josephdcaputo/microdox-tent/docs/fit_template_1to1_letter.pdf

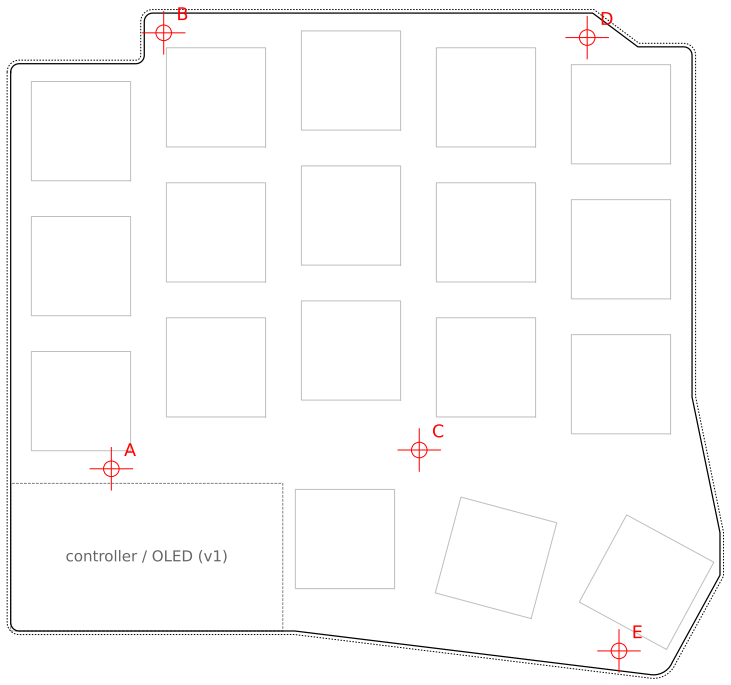
[picture p3: figure]
controller / OLED (v1)

100 mm - measure this. If it isn't 100 mm, the print is scaled: reprint at 100% / Actual size

100 mm

# Microdox LEFT half - 1:1 fit template (v1 outline + holes)

Print at 100% / Actual size (no 'fit to page'). Check both 100 mm bars with a ruler first.
Method 1 (outline): pull the outer keycaps, set the LEFT half switch-side UP on this page, and sight straight down at the PCB edge. Its inner (thumb) edge is on the right.
Method 2 (holes): remove the bottom screws, turn the RIGHT half keycaps-DOWN, and hold THIS page printed side up against its underside (the underside is a mirror image). Push a pin through each red crosshair: it should drop into the mounting hole.
Solid line = v1 PCB edge. Dashed = +0.5 mm. Red = v1 M2 hole centres A-E. Grey = v1 switch cutouts.

MATCH if: board edge sits on or just inside the solid line all the way round (paper tolerance ~0.5 mm)
and every pin drops into its hole without forcing. MISMATCH if: any edge is >1 mm off, or any hole is visibly off-centre -> stop and measure the v2 board (see REFERENCE.md).

Caliper cross-check (hole centre spacing = far-edge to far-edge - 2.2):
A-E 76.11 | B-D 59.76 | C-E 39.98 | A-D 90.62 | outline 100.09 x 93.39 mm
Pass: each within 0.2 mm.

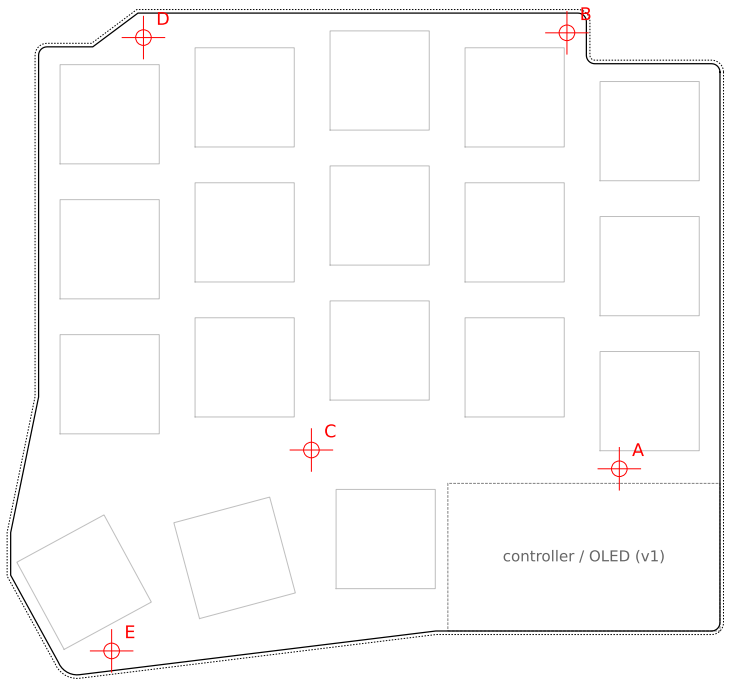
[picture p4: figure]
controller / OLED (v1)

100 mm - measure this. If it isn't 100 mm, the print is scaled: reprint at 100% / Actual size

100 mm

# Microdox RIGHT half - 1:1 fit template (v1 outline + holes)

Print at 100% / Actual size (no 'fit to page'). Check both 100 mm bars with a ruler first.
Method 1 (outline): pull the outer keycaps, set the RIGHT half switch-side UP on this page, and sight straight down at the PCB edge. Its inner (thumb) edge is on the left.
Method 2 (holes): remove the bottom screws, turn the LEFT half keycaps-DOWN, and hold THIS page printed side up against its underside (the underside is a mirror image). Push a pin through each red crosshair: it should drop into the mounting hole.
Solid line = v1 PCB edge. Dashed = +0.5 mm. Red = v1 M2 hole centres A-E. Grey = v1 switch cutouts.

MATCH if: board edge sits on or just inside the solid line all the way round (paper tolerance ~0.5 mm)
and every pin drops into its hole without forcing. MISMATCH if: any edge is >1 mm off, or any hole is visibly off-centre -> stop and measure the v2 board (see REFERENCE.md).

Caliper cross-check (hole centre spacing = far-edge to far-edge - 2.2):
A-E 76.11 | B-D 59.76 | C-E 39.98 | A-D 90.62 | outline 100.09 x 93.39 mm
Pass: each within 0.2 mm.
