josephdcaputo/microdox-tent/docs/images/board_features_top_view_v1.png

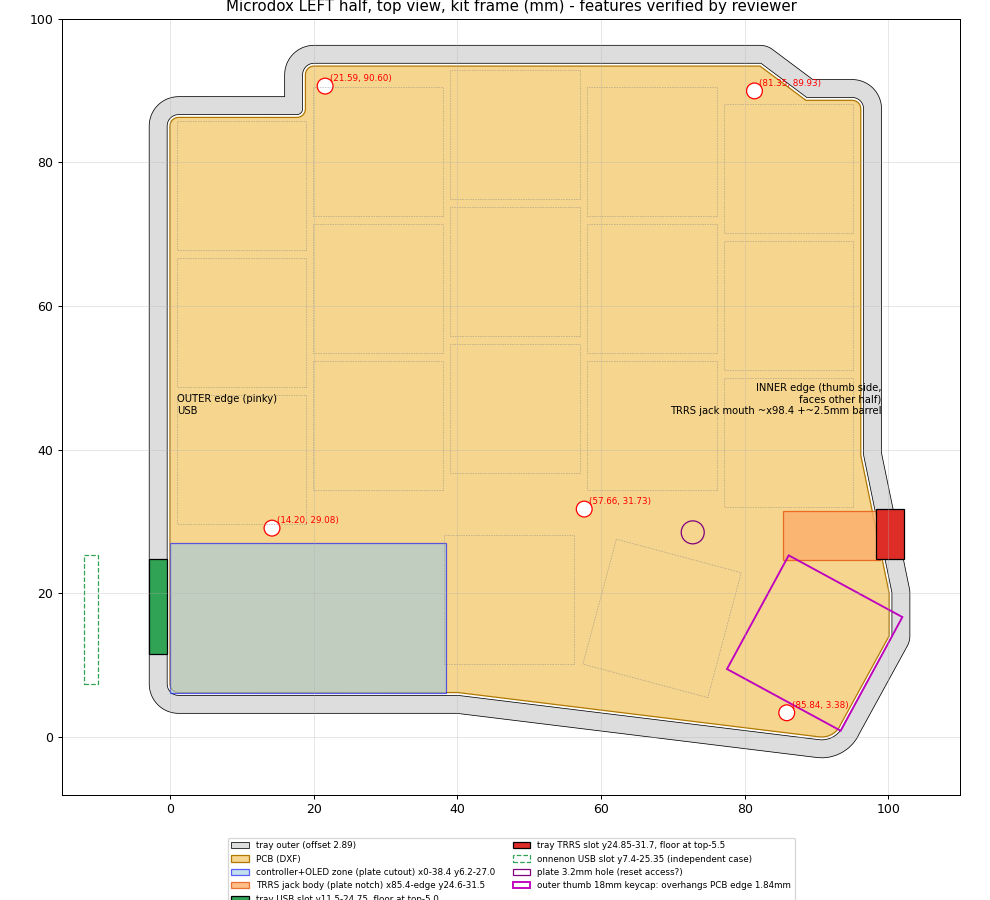
docs/images/board_features_top_view_v1.png
