josephdcaputo/microdox-tent/docs/images/joint_top.png

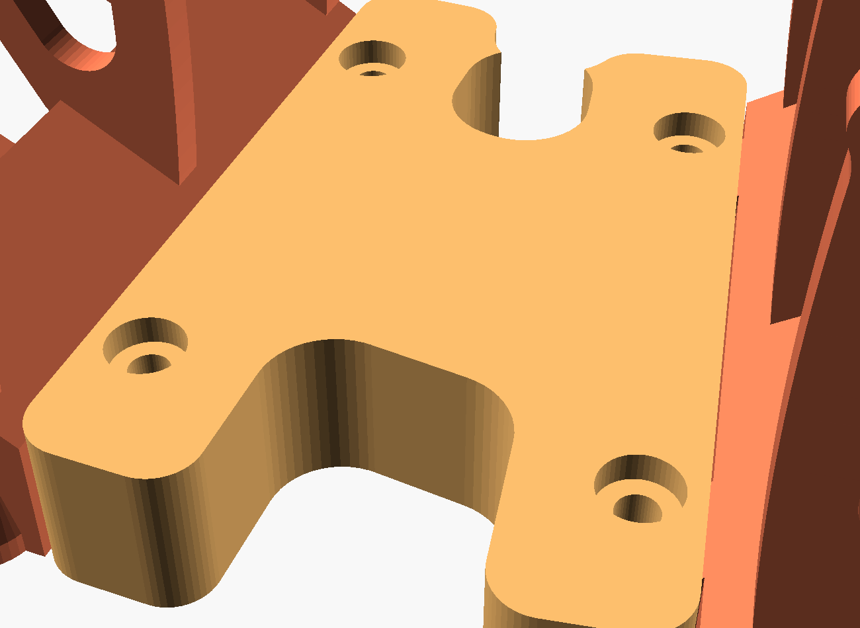
docs/images/joint_top.png
