josephdcaputo/microdox-tent/docs/images/side_views.png

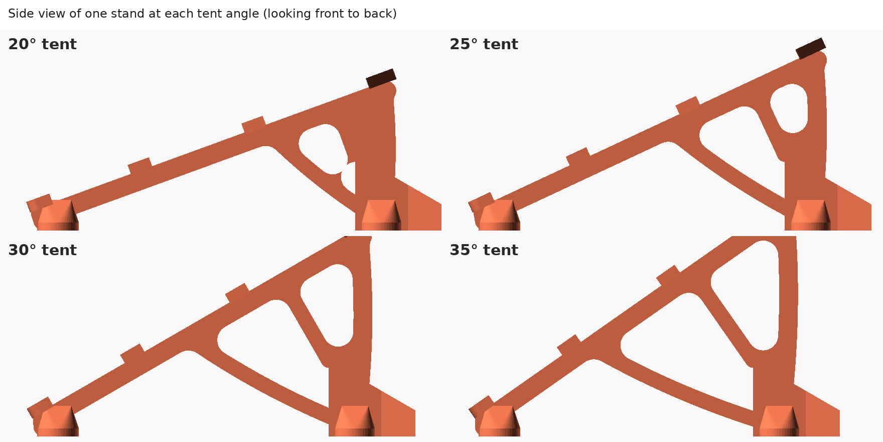
docs/images/side_views.png
