josephdcaputo/microdox-tent/docs/images/stand_underside.png

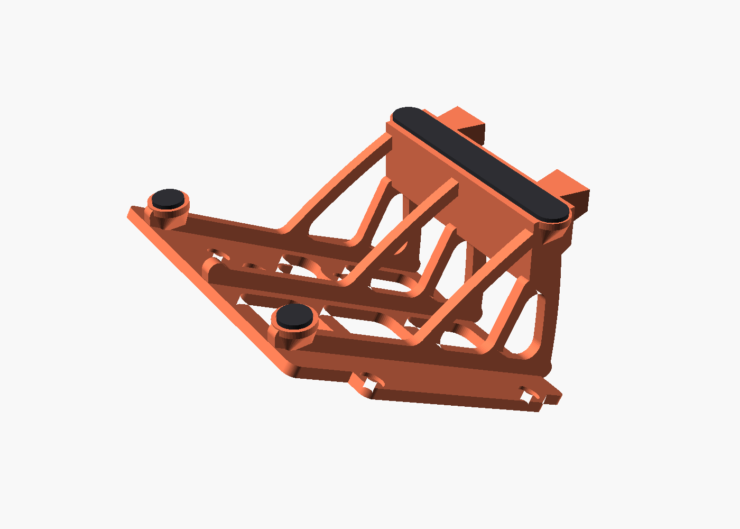
docs/images/stand_underside.png
