josephdcaputo/microdox-tent/reference/microdox_pcb_left.dxf

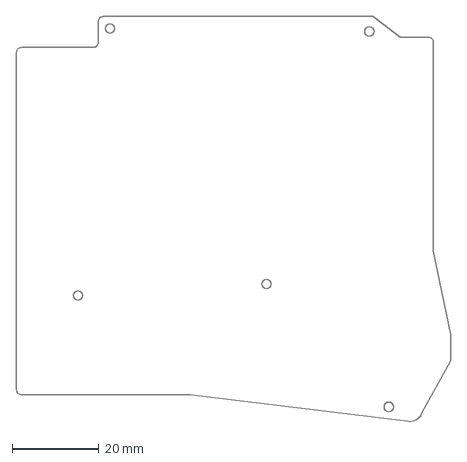
[picture p9: CAD file, 2026-10-17]
reference/microdox_pcb_left.dxf
100.1 x 93.4 mm
