josephdcaputo/microdox-tent/reference/original/Microdox.step

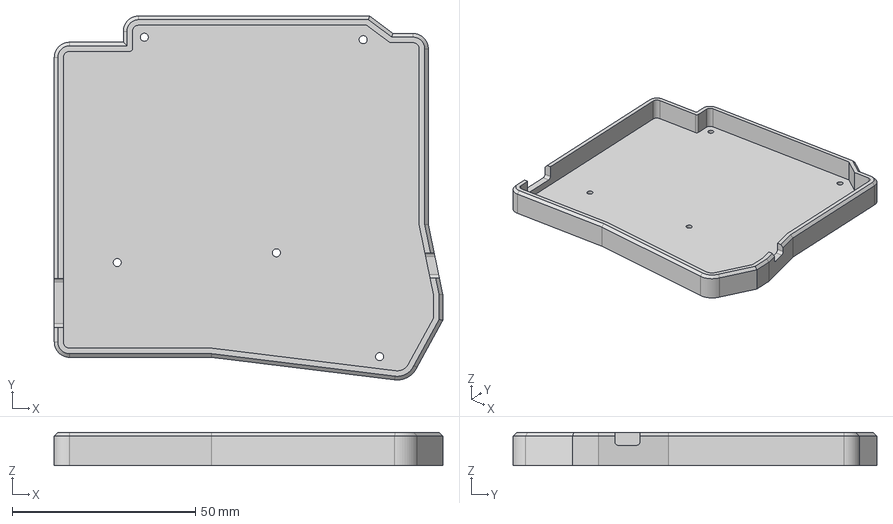
[picture p10: CAD file, 2026-10-17]
reference/original/Microdox.step
105.9 x 99.2 x 9.00 mm
