josephdcaputo/microdox-tent/stl/joint/spacer_45mm_splay10.stl

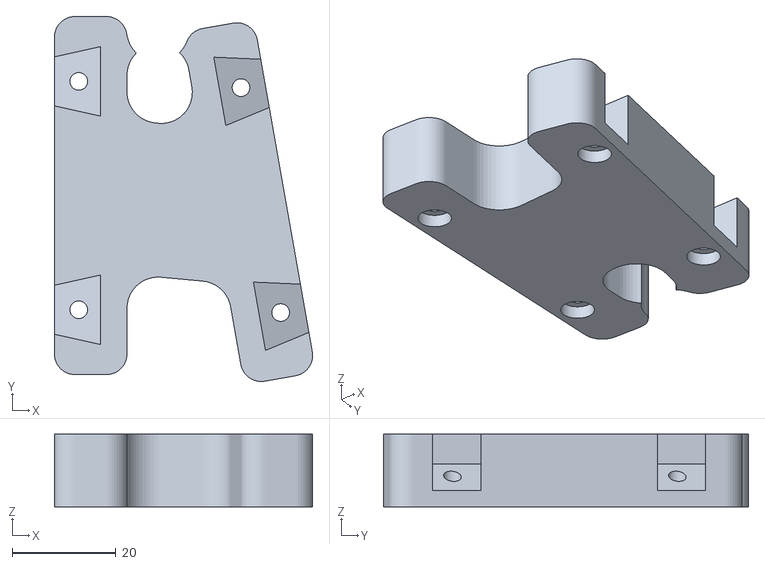
[picture p11: CAD file, 2026-10-17]
stl/joint/spacer_45mm_splay10.stl
49.8 x 70.3 x 14.0
