josephdcaputo/microdox-tent/stl/stands/stand_right_35deg.stl

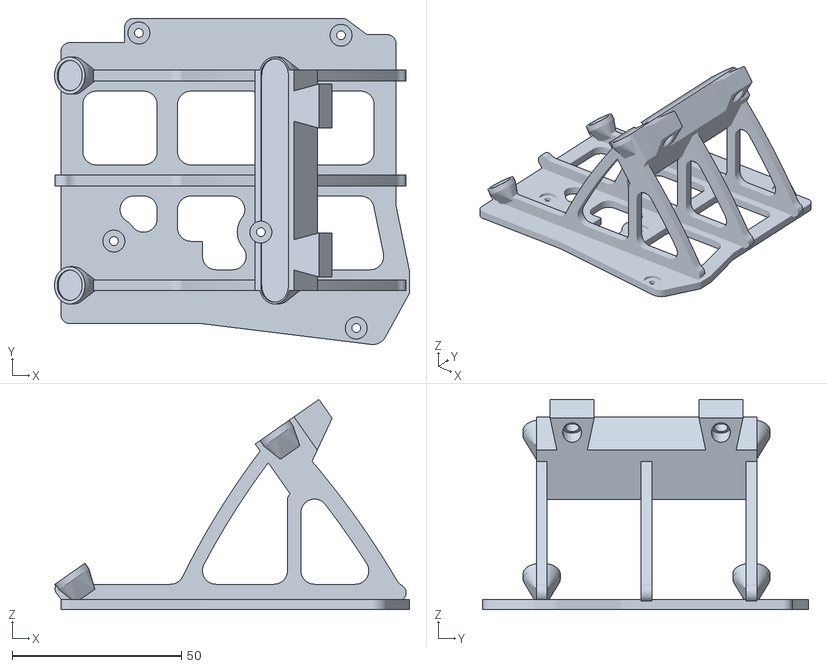
[picture p12: CAD file, 2026-10-17]
stl/stands/stand_right_35deg.stl
105.0 x 96.4 x 62.2
