josephdcaputo/microdox-tent/stl/test-prints/fit_plate.stl

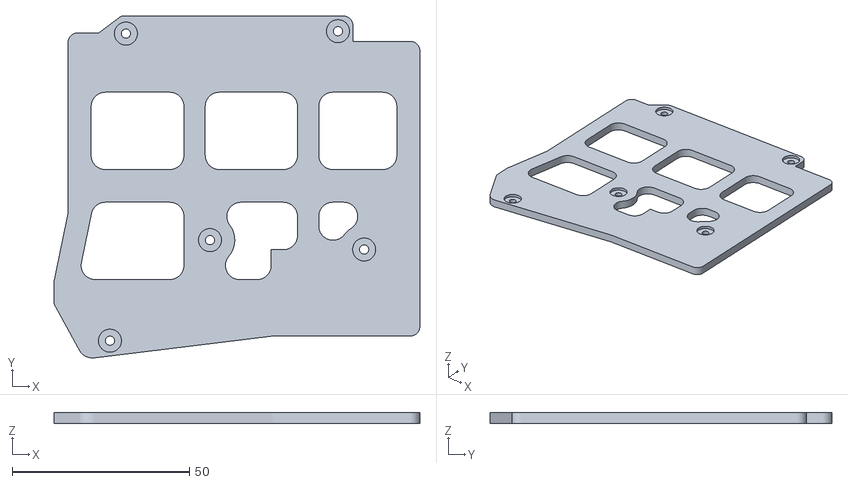
[picture p13: CAD file, 2026-10-17]
stl/test-prints/fit_plate.stl
103.1 x 96.4 x 3.00
