josephdcaputo/microdox-tent/reference/original/micodox bottom outline and holes.dxf

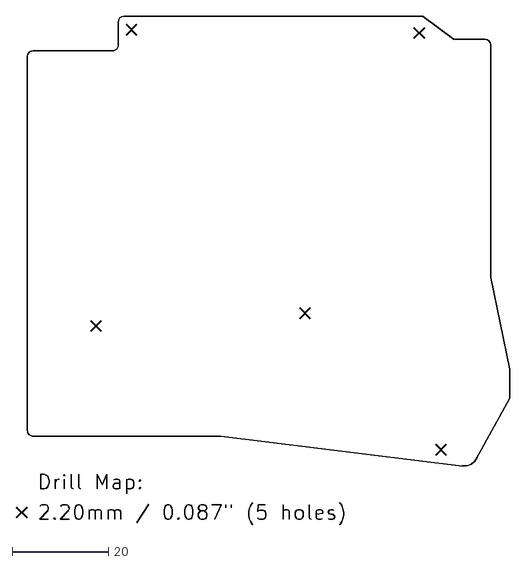
[picture p14: CAD file, 2026-10-17]
reference/original/micodox bottom outline and holes.dxf
102.4 x 105.6
