josephdcaputo/microdox-tent/stl/joint/spacer_80mm.stl

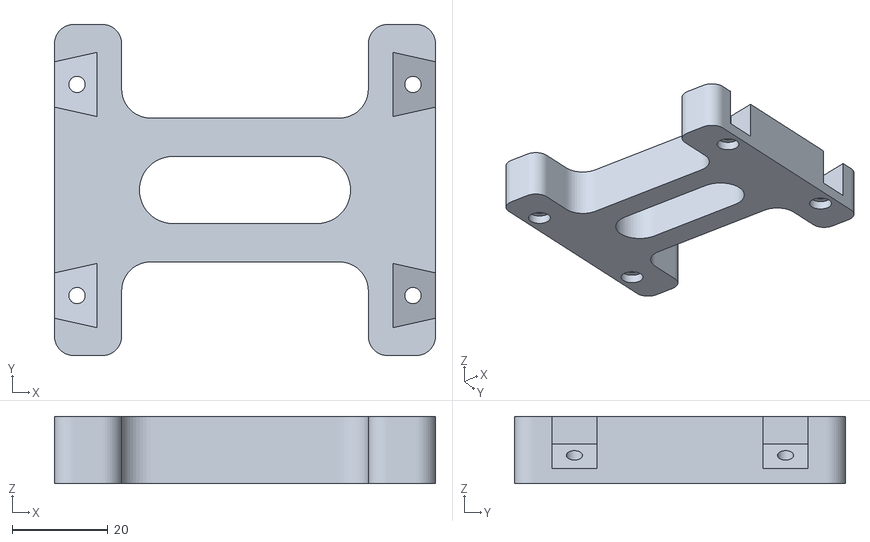
[picture p15: CAD file, 2026-10-17]
stl/joint/spacer_80mm.stl
79.4 x 69.0 x 14.0
