josephdcaputo/microdox-tent/stl/stands/stand_right_20deg.stl

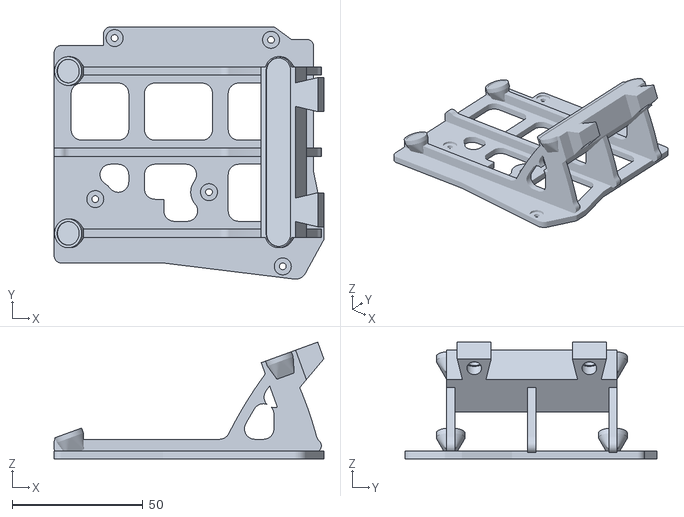
[picture p16: CAD file, 2026-10-17]
stl/stands/stand_right_20deg.stl
103.2 x 96.4 x 44.6
