josephdcaputo/microdox-tent/stl/test-prints/joint_test_tongue.stl

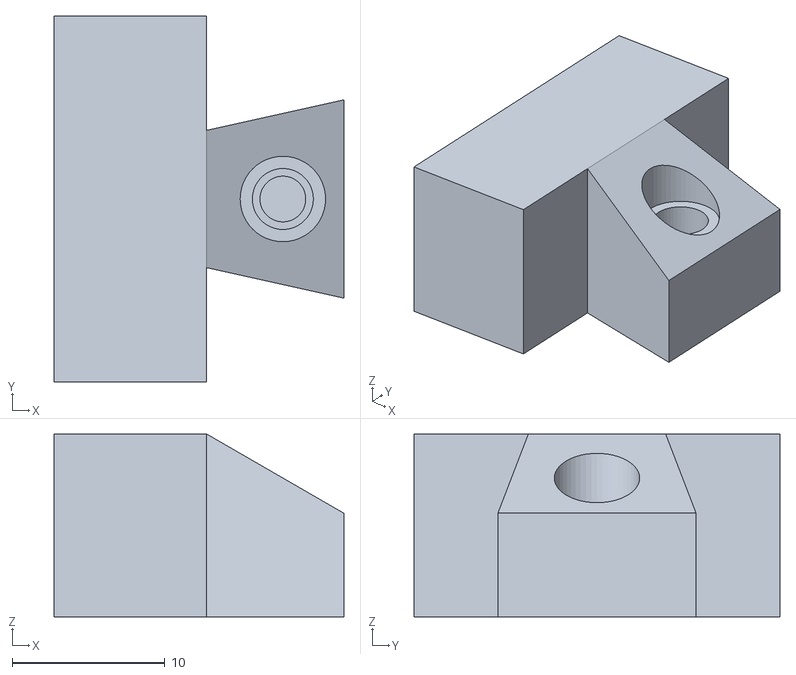
[picture p17: CAD file, 2026-10-17]
stl/test-prints/joint_test_tongue.stl
19.0 x 24.0 x 12.0
