josephdcaputo/microdox-tent/stl/joint/spacer_40mm.stl

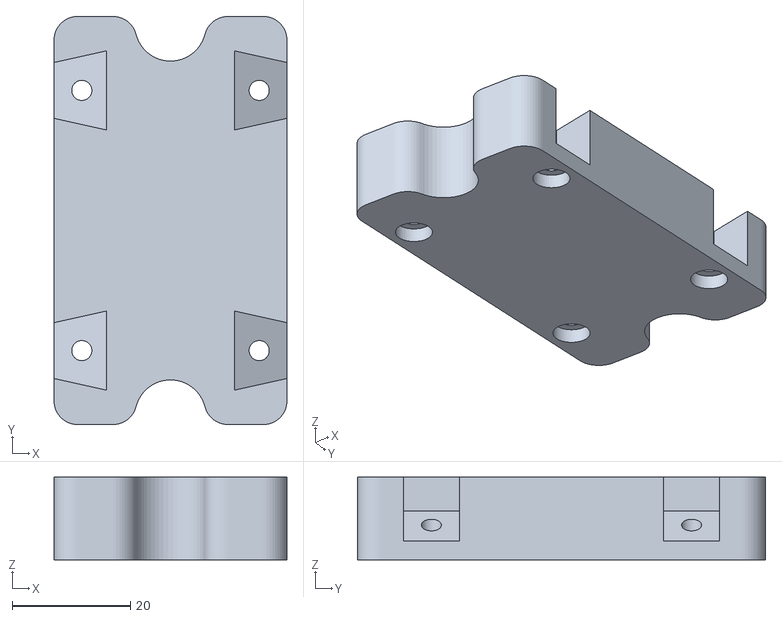
[picture p18: CAD file, 2026-10-17]
stl/joint/spacer_40mm.stl
39.4 x 69.0 x 14.0
