josephdcaputo/microdox-tent/stl/test-prints/joint_test_socket.stl

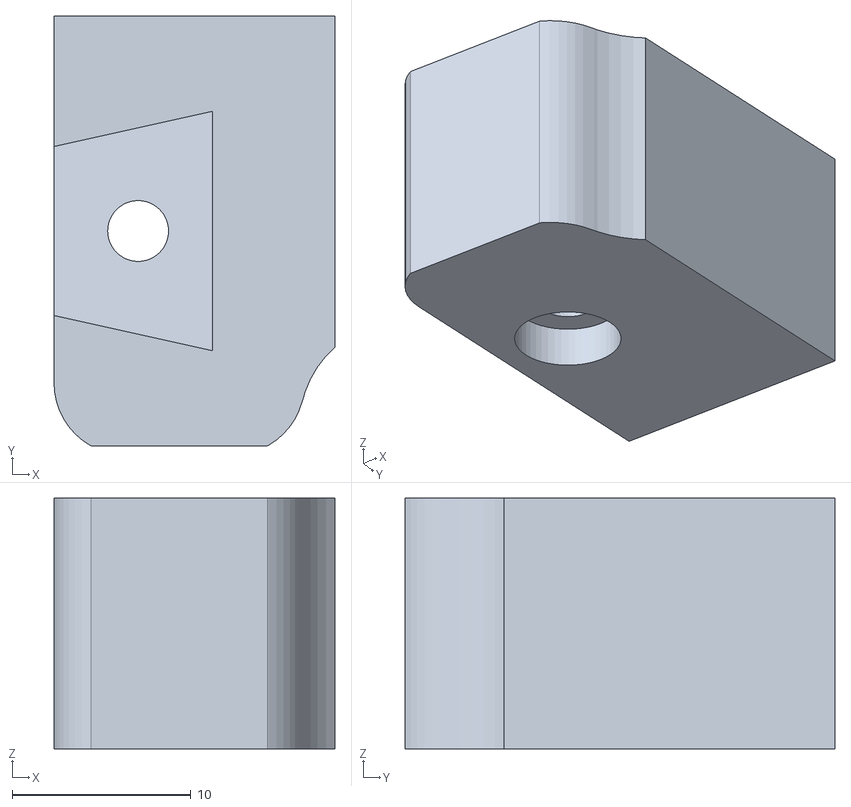
[picture p19: CAD file, 2026-10-17]
stl/test-prints/joint_test_socket.stl
15.7 x 24.0 x 14.0
