josephdcaputo/microdox-tent/stl/joint/coupler.stl

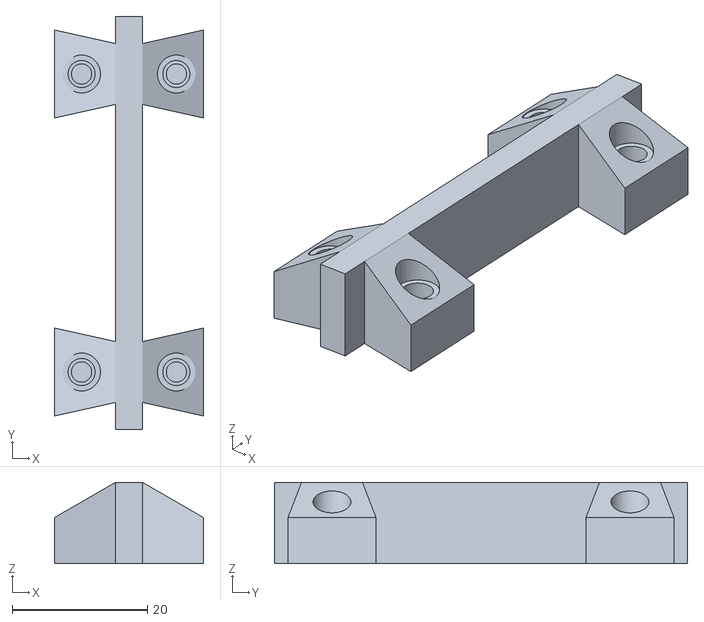
[picture p20: CAD file, 2026-10-17]
stl/joint/coupler.stl
22.0 x 61.0 x 12.0
