josephdcaputo/microdox-tent/stl/stands/stand_left_25deg.stl

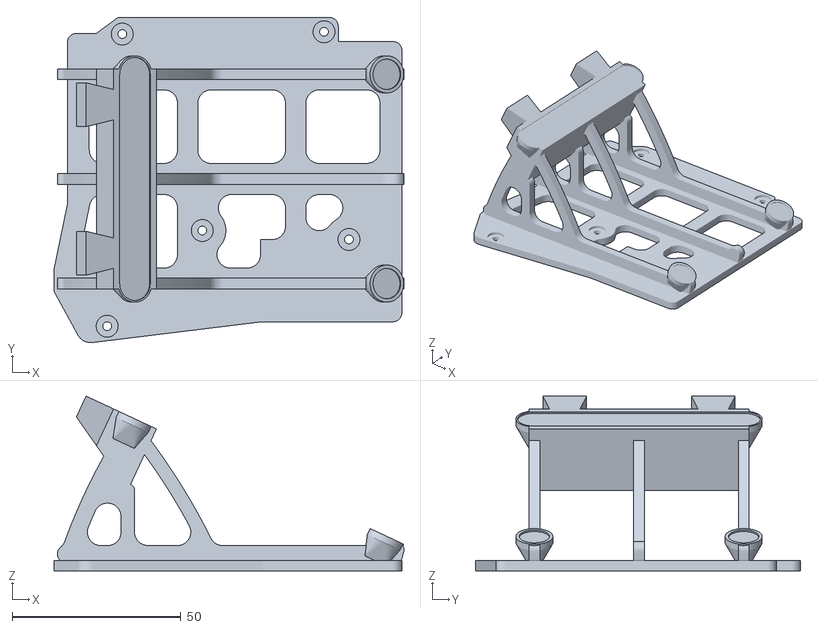
[picture p21: CAD file, 2026-10-17]
stl/stands/stand_left_25deg.stl
103.7 x 96.4 x 51.8
