josephdcaputo/microdox-tent/stl/joint/spacer_60mm.stl

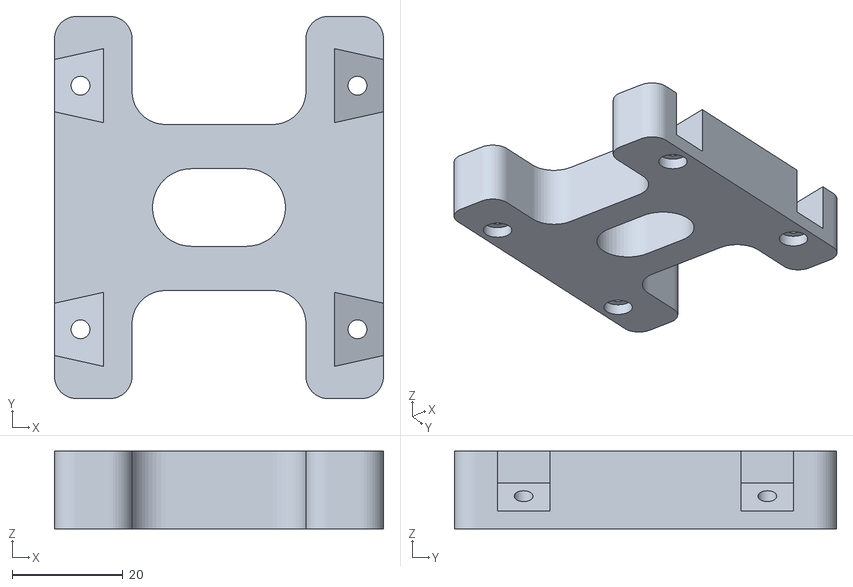
[picture p22: CAD file, 2026-10-17]
stl/joint/spacer_60mm.stl
59.4 x 69.0 x 14.0
