josephdcaputo/microdox-tent/stl/stands/stand_right_30deg.stl

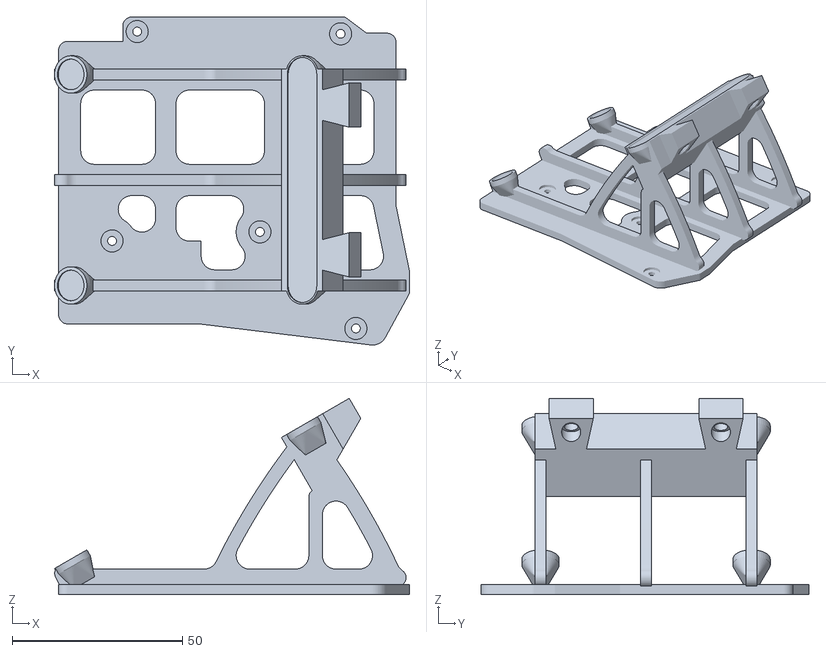
[picture p23: CAD file, 2026-10-17]
stl/stands/stand_right_30deg.stl
104.3 x 96.4 x 57.7
