josephdcaputo/microdox-tent/(list of files, cad)

Other CAD files:
stl/stands/stand_left_35deg.stl
stl/stands/stand_left_20deg.stl
stl/stands/stand_right_25deg.stl
stl/stands/stand_left_30deg.stl
