josephdcaputo/microdox-tent/docs/images/stand_print_orientation.png

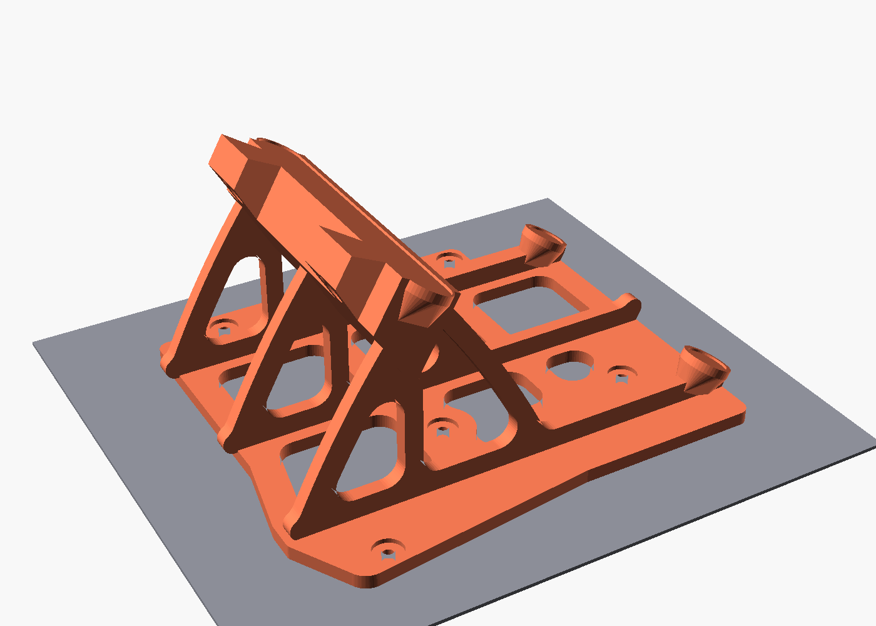
docs/images/stand_print_orientation.png
