josephdcaputo/microdox-tent/(commit log)

2026-10-17 Microdox v2 tenting stand: parametric OpenSCAD design, STLs, checker
    Rib-frame stand per half (replaces the stock bottom plate, 20-35 deg tent),
    dovetail spacers with sloped-seat clamp, coupler for chains, fit-plate and
    joint test prints, silicone pad recesses. Rod keel kept as an option, off
    by default. Checker passes at 20/25/30/35 deg and a 40+60 mm chain.
    Claude-Session: https://claude.ai/code/session_01BVGEVgPWqrYpTQPq61aEVx
    [Microdox.step, coupler.stl, fit_plate.stl, joint_test_socket.stl, joint_test_tongue.stl, micodox bottom outline and holes.dxf, microdox_pcb_left.dxf, microdox_ref.scad]
2026-10-18 Remove the rod keel completely
    Drops the rod/eye option from the design, the checker and the stability
    script. Printed parts are unchanged (re-exported stands, spacer and fit
    plate have identical triangles). The checker keeps a general "only the feet
    reach the desk" check. Re-checked at 20/25/30/35 deg and a 40+60 mm chain:
    all pass.
    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
    [microdox_ribs.scad]
